Arachne397/Manta-Ray/projekt_prezentacia.pdf

# Manta Ray

# Animaltronics

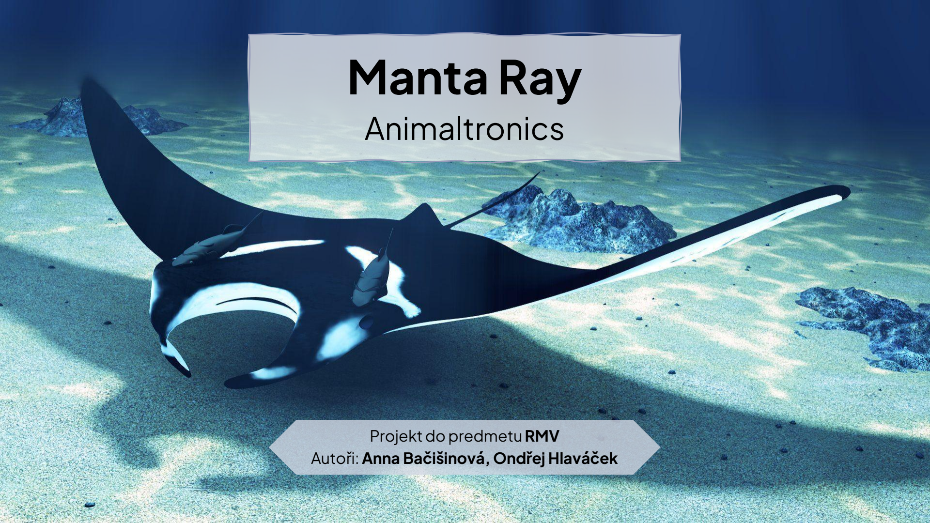
[picture p14: page 1]

Projekt do predmetu RMV
Autoři: Anna Bačišinová, Ondřej Hlaváček

## Mechanický model ►

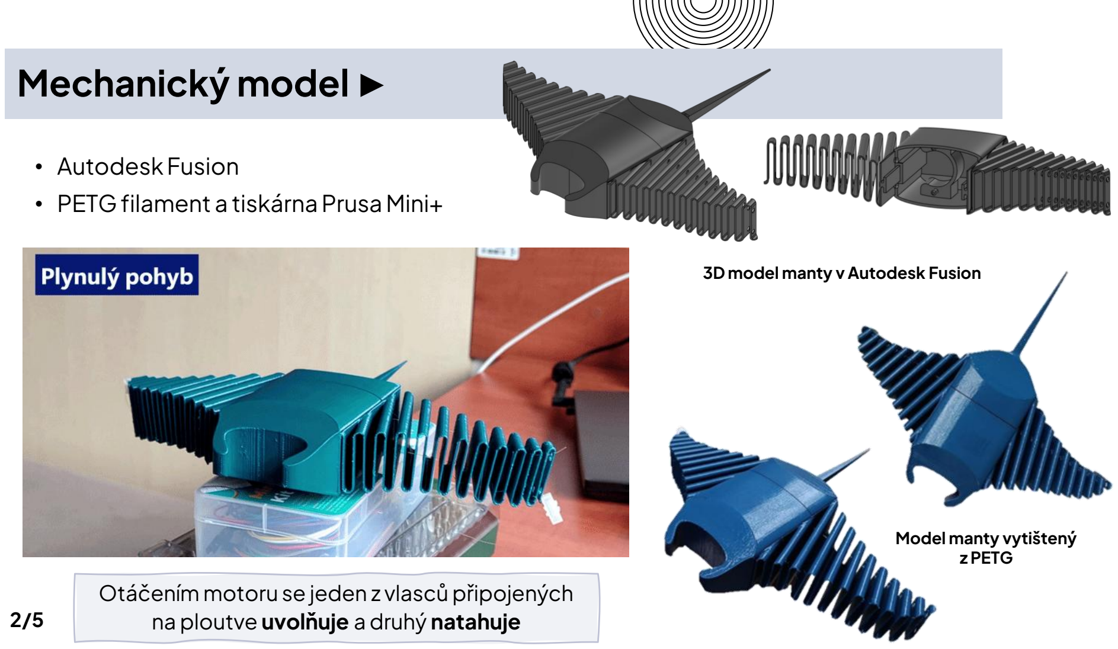
[picture p15: page 2]

3D model manty v Autodesk Fusion

- Autodesk Fusion
- PETG filament a tiskárnaPrusa Mini+

2/5

Otáčením motoru se jeden z vlasců připojených na ploutve uvolňuje a druhý natahuje

Model manty vytištený
z PETG

## Řídící elektronika ►

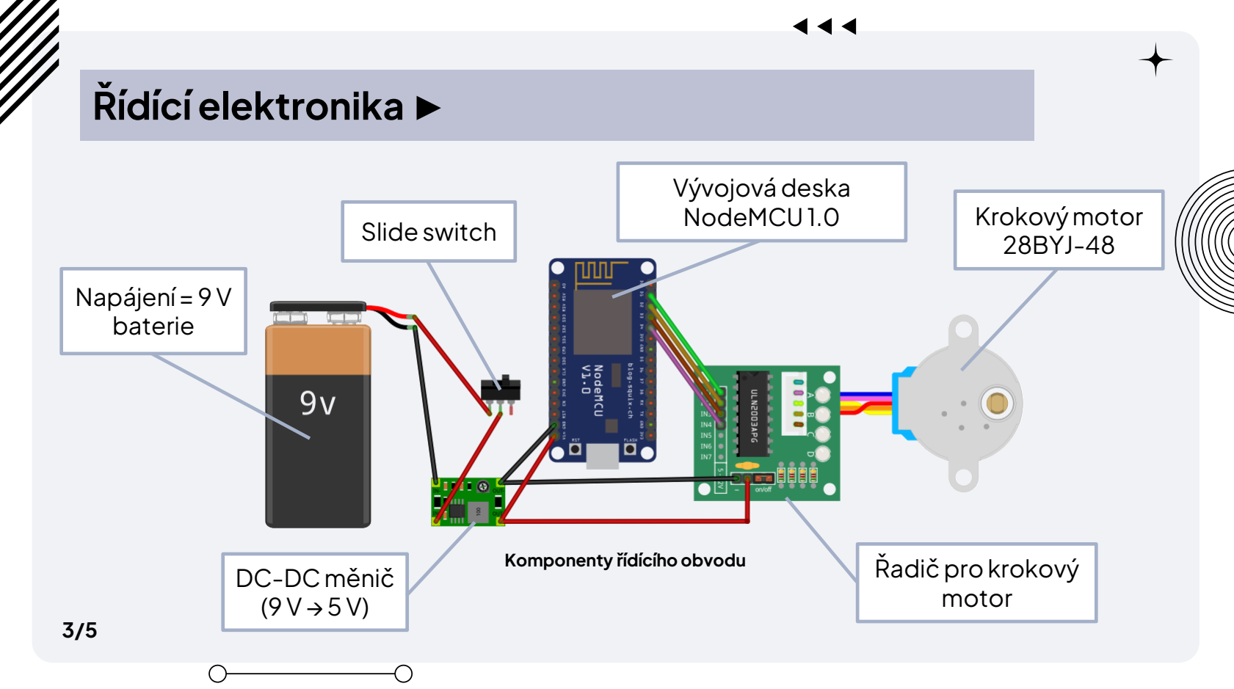
[picture p16: page 3]

3/5

Komponenty řídícího obvodu

Napájení = 9 V
baterie

DC-DC měnič
(9 V → 5 V)

Slide switch

Vývojová deska
NodeMCU 1.0

Řadič pro krokový
motor

Krokový motor
28BYJ-48

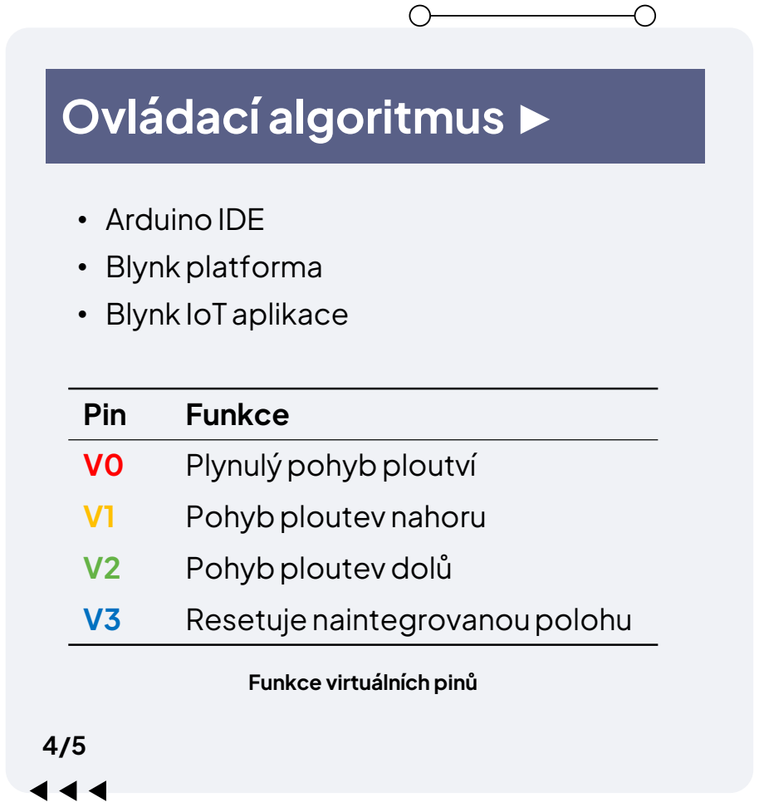
[picture p17: figure]
Ovládací algoritmus ►; Pin; Funkce; Plynulý pohyb ploutví; Pohyb ploutev nahoru; Pohyb ploutev dolů; Resetuje naintegrovanoupolohu; • Arduino IDE • Blynk platforma • Blynk IoT aplikace; Funkce virtuálních pinů
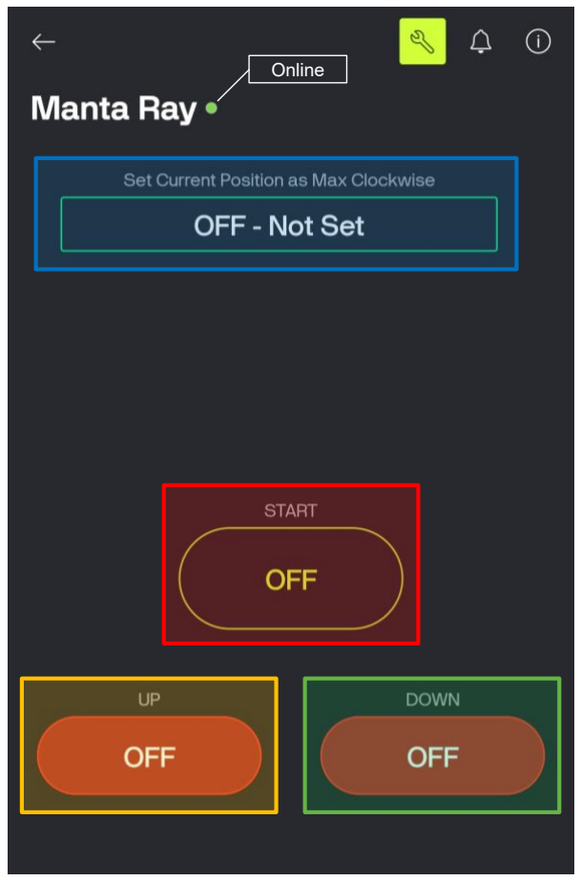
[picture p18: figure]
Online

Ovládací prostředí v aplikaciBlynk IoT

# Ďakujeme

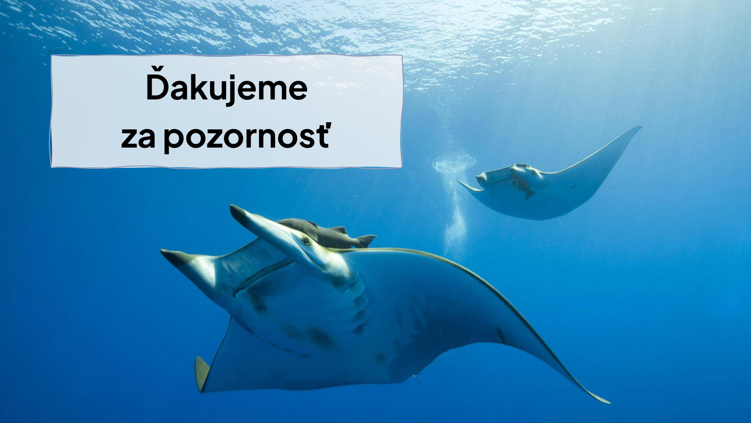
[picture p19: page 5]

# za pozornosť
